audiyofan/PP-EL360/images/PP_EL36_6N2P_6F12P.png

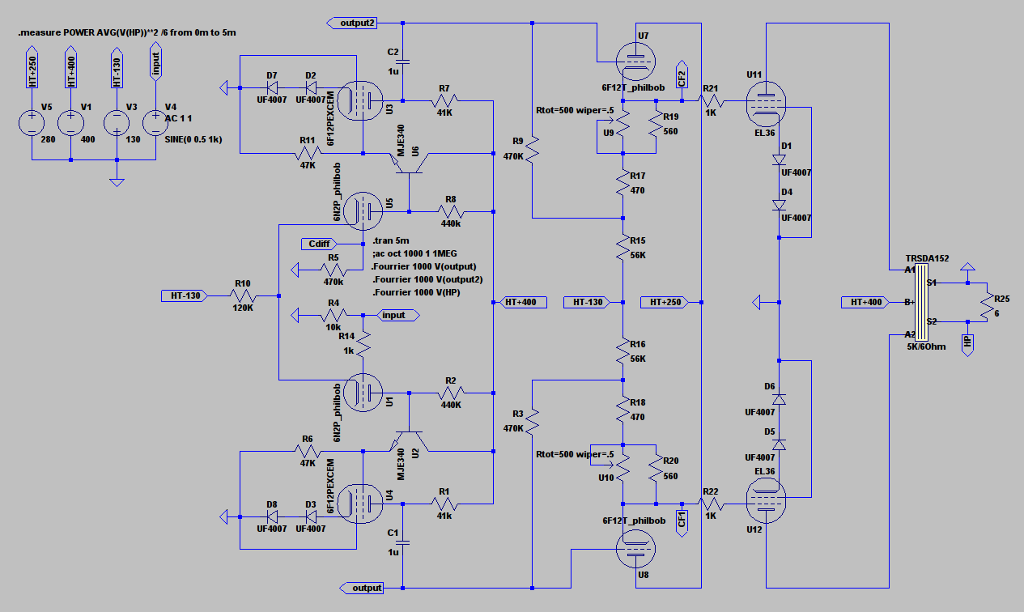
images/PP_EL36_6N2P_6F12P.png
