audiyofan/PP-EL360/images/PP_EL360_plot.png

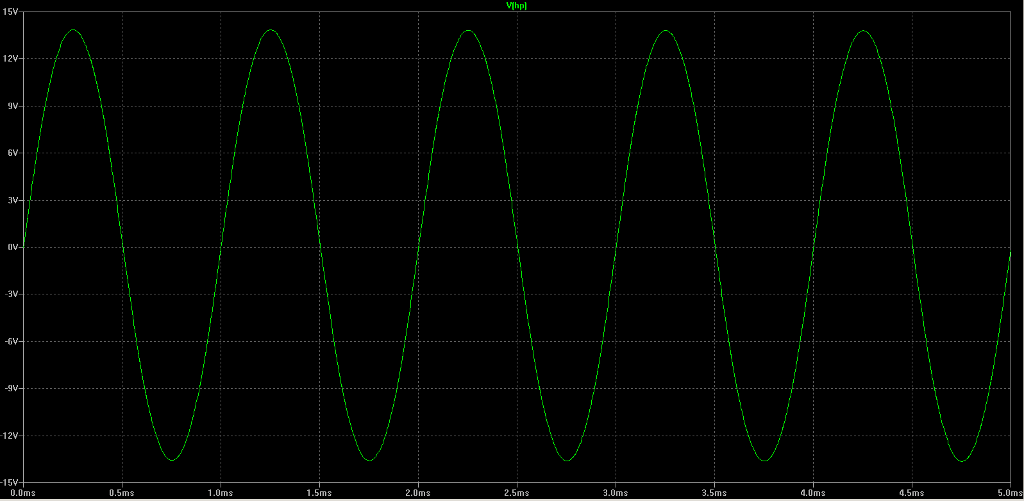
images/PP_EL360_plot.png
