audiyofan/PP-EL360/images/PP_EL360_schema.png

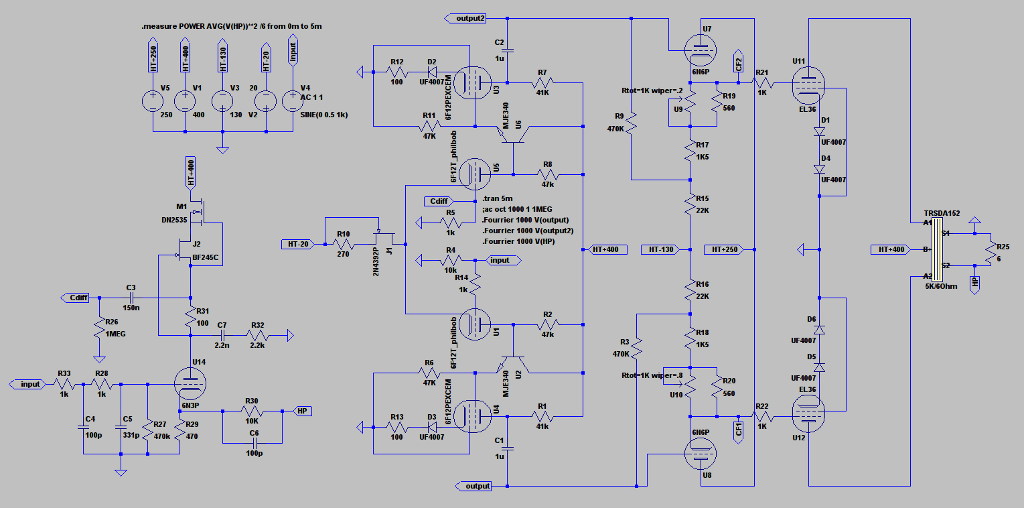
images/PP_EL360_schema.png
