audiyofan/PP-EL360/LTspiceIV/psu_neg.asc

C1: cap; 100µ; Rser=2
C2: cap; 100µ; Rser=2
C3: cap; 1m; Rser=2
C4: cap; 100µ; Rser=2
C5: cap; 50µ; Rser=.5
C6: cap; 200µ; Rser=1
C7: cap; 4.7µ
C8: cap; 15µ
C9: cap; 4.7µ; Rser=3
C10: cap; 4.7µ; Rser=3
C11: cap; 100µ
D1: zener; BZX384B9V1
D2: schottky; 1N5819
D3: schottky; 1N5819
D4: diode; 1N6513
D5: diode; 1N6513
D6: diode; 1N6513
D7: diode; 1N6513
D8: LED; XM-LRED
D9: zener; BZX384B9V1
D10: zener; 1N5378B
D11: schottky; 1N5819
D12: zener; BZX384B9V1
D15: LED; XM-LGRN
I4: current; PULSE(0m 100m 60 5u 5u 590u 1m 5000)
Q2: pnp; MJE350
R1: res; 1
R2: res; 270
R3: res; 910
R4: res; 180k
R5: res; 110k
R6: res; 180k
R7: res; 100k
R8: res; 100k
R9: res; 75
R10: res; 1800
R11: res; 120
R12: res; 450
R13: res; 11765
R14: res; 2k
R15: res; 10.57k
R16: res; 21875
R17: res; 10k
R18: res; 680k
R19: res; 6.8k
R20: res; 100k
U1: IRF820
U2: lm337
U3: IRF820
U4: IRF820
U5: IRF820
V1: voltage; SINE(0 17 50 0 0 0 3800); AC 1 1; Rser=2.35
V2: voltage; SINE(0 420 50 0 0 0 3800); AC 1 1; Rser=41.4
Named nets: 0, +320, V-, +330, +200, ref
.tran 80s
* MCR100-8  SCR  A G K  MCE  7-17-95
*MCE MCR100-8 600V  800mA  pkg:TO-226AA
.SUBCKT XMCR1008 1 2 3
*    TERMINALS:  A G K
*  600 Volt  .8 Amp  SCR  07-17-1995
QP  6 4 1  POUT OFF
QN  4 6 5  NOUT OFF
RF  6 4    120MEG
RR  1 4    80MEG
RGK 6 5    6.25K
RG  2 6    9.17
RK  3 5    81.3M
DF  6 4    ZF
DR  1 4    ZR
DGK 6 5    ZGK
.MODEL ZF   D (IS=.32F IBV=1U BV=600 RS=18MEG)
.MODEL ZR   D (IS=.32F IBV=1U BV=800)
.MODEL ZGK  D (IS=.32F IBV=1U BV=5)
.MODEL POUT PNP (IS=320F BF=1 CJE=67P)
.MODEL NOUT NPN (IS=320F BF=100 RC=.325
+ CJE=67P CJC=13.4P TF=56.6N TR=8.06U)
.ENDS XMCR1008
