audiyofan/PP-EL360/LTspiceIV/amplifier.asc

C1: cap; 1µ; Rser=0.03
C2: cap; 1µ; Rser=0.03
C3: cap; 10p
C4: cap; 12p
C6: cap; 470n
C7: cap; 2.2n
C8: cap; 270p
C9: cap; 20p
C10: cap; 12p
D1: LED; LedGreen
D2: LED; XM-LRED
D3: LED; XM-LRED
D4: LED; LedRed
I1: current; 0.8m
Q1: npn; MPSA42
Q2: npn; MPSA42
Q3: pnp; MJE350
Q4: npn; BC547C
Q5: npn; BC547C
R1: res; {Rload}
R2: res; {Rload}
R3: res; 470k
R4: res; {Rccs}
R5: res; 470k
R6: res; {Rk}
R7: res; 120
R8: res; 5.1k
R9: res; {Rccs}
R10: res; 470k
R11: res; {Rk}
R12: res; 100k
R13: res; 4.4k
R14: res; 8
R15: res; 4k
R16: res; 6k
R17: res; 470k
R18: res; 2.2k
R19: res; 240
R20: res; 470k
R21: res; 2.7k
R22: res; 120
R23: res; 4k
R24: res; 1.8k
U1: triode; 6F12PT
U2: triode; 6F12PT
U3: triode; 6F12PT
U4: tetrode_pentode; EL36
U5: triode; 6N3P-E
U6: triode; 6F12PT
U7: tetrode_pentode; EL36
U10: TRSDA6S19P
V1: voltage; SINE(200 .5m 100)
V2: voltage; SINE(330 5m 100)
V3: voltage; SINE(19.6 0.05m 100)
V4: voltage; SINE(0 0.15 1k); AC 1 1
V5: voltage; SINE(310 0.3 100)
Named nets: 0, Vneg, input, HT1, HT2, V+, V-, HT3, output, Vg1+, Vg1-, CDiff
.tran 60m
.Fourrier 1000 V(output)
.Fourrier 1000 V(V+)
.measure OUTPUT_POWER_RMS RMS(V(output))*I(R14)
;ac oct 5000 .01 10MEG
*--------------------------------
.SUBCKT TRSDA6S19P 1 2 3 4 5 PARAMS:
+Lprim = 122 ; inductance totale du primaire entre plaques en henrys
+Zpp=5000 ; impédance primaire entre plaques
+Zhp=4 ; impédance HP
+Kp = 0.33 ; rapport des prises sur l'enroulement primaire par rapport au pt central (0<KE<1)
* attention pour les utiliser il faut modifier le symbole et rajouter les pin 6 et 7 ainsi
* qu'un label P1 et P2 et rajouter ci-dessus les pin 6 et 7 dans la ligne SUBCKT ....
+Rprim=112 ; résistance totale du primaire entre plaques
+Rsec=.22 ; résistance du secondaire
+Lfp=9m ; inductance de fuite ramenée au primaire en Henry
+Ca1=79p ; capacité parasite enroulement d'anode1
+Ca2=79p ; capacité parasite enroulement d'anode2
+Ce1=300p ; capacité parasite enroulement d'écran1
+Ce2=300p ; capacité parasite enroulement d'écran2
 
LP1 8 6 {Lprim/4+Lprim*Kp*Kp/4-Lprim*Kp/2}
LP2 6 5 {Lprim*Kp*Kp/4}
LP3 5 7 {Lprim*Kp*Kp/4}
LP4 7 9 {Lprim/4+Lprim*Kp*Kp/4-Lprim*Kp/2}
LP5 10 4 {LPRIM*Zhp/Zpp}
RP1 1 8 {Rprim/2}
RP2 2 9 {Rprim/2}
RS 10 3 {Rsec}
KALL LP1 LP2 LP3 LP4 LP5 {SQRT(1-Lfp/Lprim)} ; {coeff de couplage}
c1 1 8 {Ca1}
c2 2 9 {Ca2}
c3 6 5 {Ce1}
C4 5 7 {Ce2}
.ENDS
.PARAM Rccs 270
.PARAM Rk 220
.PARAM Rload 47k
.PARAM Rloadccs 100k
parameters & measures
