audiyofan/PP-EL360/LTspiceIV/drivers.asc

C1: cap; 1µ; V=100 Irms=4.58 Rser=0.025 Lser=0 mfg="KEMET" pn="C2225C105K1RAC" type="X7R"
C2: cap; 1µ; V=100 Irms=4.58 Rser=0.025 Lser=0 mfg="KEMET" pn="C2225C105K1RAC" type="X7R"
D1: diode; UF4007
D2: diode; UF4007
D3: diode; UF4007
D4: diode; UF4007
Q1: npn; MJE340
Q2: npn; MJE340
R1: res; 56k
R2: res; 220k
R3: res; 470K
R4: res; 10k
R5: res; 58k
R6: res; 82
R7: res; 56K
R8: res; 220k
R9: res; 470K
R10: res; 1k
R11: res; 82
R14: res; 1k
R15: res; 15K
R16: res; 15K
U16: triode; 12AX7
U17: triode; 12AX7
U18: triode; 6F12PT
U19: triode; 6F12PT
U20: tetrode_pentode; 6F12PP
U21: tetrode_pentode; 6F12PP
V1: voltage; 400
V3: voltage; 130
V4: voltage; SINE(0 0.35 1k); AC 1 1
V5: voltage; 200
Named nets: input, 0, HT+400, HT-130, HT+200, CF2, CF1
.Fourrier 1000 V(CF1)
.tran 50m
.Fourrier 1000 V(CF2)
;ac oct 1000 1 1MEG
.SUBCKT 6F12PT 1 2 3 ; P G C (Triode) 07 Nov 2004
+ params:
+ mu  = 137.721
+ ex  = 1.60508
+ kg1 = 55.4076
+ kp  = 593.725
+ kvb = 11210.8
+ ccg = 4.6e-12
+ cgp = 1.6e-12
+ ccp = 2.6e-13
e1 7 0 value=
+{v(1,3)/kp*log(1+exp(kp*(1/mu+v(2,3)/sqrt(kvb+v(1,3)*v(1,3)))))}
re1 7 0 1g
g1 1 3 value= {(pwr(v(7),ex)+pwrs(v(7),ex))/kg1}
rcp 1 3 1g
c1 2 3 {ccg}
c2 1 2 {cgp}
c3 1 3 {ccp}
.ENDS
.SUBCKT 6F12PP  1 2 3 4 ; P G1 C G2 (Pentode) 24-Dec-2004
+ PARAMS: MU= 71.45  EX= 1.350  KG1= 260.8  KP=7396.95   KC= 75
+ KVB=  17.9  VCT=  0.00 RGI=  4500k
+ CCG=6.6P  CPG1=0.02P CCP=1.9P
RE1  7 0  1MEG    
E1   7 0  VALUE=  ; E1 BREAKS UP LONG EQUATION FOR G1.
+{V(4,3)/KP*LN(1+EXP((1/MU+V(2,3)/V(4,3))*KP))}
G1   1 3  VALUE={(PWR(V(7),EX)+PWRS(V(7),EX))/KG1*1.57*TANH(2*V(1,3)/(KVB*3.14159))}
G2   4 3  VALUE={STP(((EXP(EX*(LN((V(4,3)/MU)+V(2,3)))))/KC)-((PWR(V(7),EX)+PWRS(V(7),EX))/KG1*1.57*TANH(2*V(1,3)/(KVB*3.14159))))
+*(((EXP(EX*(LN((V(4,3)/MU)+V(2,3)))))/KC)-((PWR(V(7),EX)+PWRS(V(7),EX))/KG1*1.57*TANH(2*V(1,3)/(KVB*3.14159))))}
RCP  1 3  1G      ; FOR CONVERGENCE
C1   2 3  {CCG}   ; CATHODE-GRID 1
C2   1 2  {CPG1}  ; GRID 1-PLATE
C3   1 3  {CCP}   ; CATHODE-PLATE
R1   2 5  {RGI}   ; FOR GRID CURRENT
D3   5 3  DX      ; FOR GRID CURRENT
.MODEL DX D(IS=1N RS=1 CJO=10PF TT=1N)
.ENDS
