audiyofan/PP-EL360/(threads)

Thread 1 (2015-10-30):

+200V power supply starts with positive offset

chanmix51, 2015-10-30:
The +200V power supply is provided by an IRF polarized by a CCS. The FET’s gate is not decoupled so it will start with a positive offset that will set the EL360’s grid 2 to a positive offset at start up.

[Bug report](http://www.audiyofan.org/forum/viewtopic.php?f=60&t=9195&p=117088#p117088) (french)

chanmix51, 2015-11-14:
Fixed in 0a6318e

Closed 2015-11-14.
