audiyofan/PP-EL360/(commit log)

2014-09-13 Rajoût des modèles 6N6P & EL36, et une ébauche de PP
2014-09-14 Ajoût de la Cdiff avec une 6N3P
2014-09-14 Ajouté def. tubes.
2015-03-23 Use triode mode for entry stage.
2015-03-30 Add schematics.
2015-04-04 Set a better CCS in preamp stage.
2015-04-06 Update schematics with PSRR.
2015-04-08 Add NPN -20V regulation.
2015-04-10 Add power stage schematic.
2015-04-10 Add licence terms on schematics.
2015-04-10 Change PSU schematic s font.
2015-04-11 Fix schematics components values.
2015-04-11 Remove EL360 LED biasing.
2015-04-18 Switch 6F12P pentodes and triodes.
2015-10-25 Fix schematic bad G2 connection
2015-11-04 Fix EL360 g1 grid current problem
    Since the EL360 grid 1 are almost 0 they are subject to grid current. As
    they are biased through resistors, this makes the final stage to
    oscilate at high frequency.
2015-11-06 Change 6N3P to 6N17B
    Because the correction circuit uses a differential amplifier, its gain
    is devided by 2. With µ=35 it makes a 6N3P to provide a gain between 10
    and 15. In order to get a good enough damping factor, a higher gain is
    desirable while keeping the CMRR and PSRR of the 6N3P. The 6N17B has
    been found as beeing a suitable replacement giving an estimated gain of
    28 with a comparable ripple rejection ratio and with a better protection
    against microphony.
2015-11-13 Replace CDiff with 6N3P µ-follower
    As stated, the differential pair was not worth two tubes to present
    normal PSRR and CMRR to the 0V. A FET driven µ-follower has been
    prefered. It presents a load of 500k and an output impedance of less
    than 100Ω while keeping noise away from the FET’s source. The µ-follower
    has also the advantage of having two outputs: one (used here) is the
    FET’s source and the other is the high impedance valve’s anode. This is
    a perfect place to set a damping circuit if needed.
2015-11-14 Use LM in negative regulated power supply
    A LM happily replaces the BC338 in the negative PSU. With a RC filter it
    makes the ripple voltage under 0,1mV without further changes.
2015-11-22 Rearrange PSU and drivers
    With 300Vac output at main transformer, we are able to get a regulated
    330Vdc for drivers. Still, it presents a 10mV ripple @ 100Hz. The
    regulated 200Vdc does not present such ripple. The CDiff can be powered
    from the 200V since it uses a FET µ-follower.
    PSU currents have been simulated to check the amplifier can stand
    maximum output without the PSU to choke.
    The regulation is now preceded by a RC filter that lowers the ripple of
    6dB.
2016-03-09 raise Rgrid right to 470k
    Because we use a mechanical switch to shortcut the output when switched
    off, there is no need to limit the PLOP when the voltage suddenly drops
    in the correction stage.
2016-03-28 add BJT cascode in the input stage
2016-09-07 update schematics to first working version
    CCS bias resistors values are based on real values
    CDiff filters are updated as well
    Added a NPN in the EL360’s g2 grid circuit. This shown improvements in
    the max power the amplifier could output (25W instead of 20W) using only
    one way.
2016-09-10 lower Δ BW
    This makes better squares at 20kHz.
2016-09-10 lower I in EL360 grid track
    In order to save some precious -20V PSU milliamps.
2016-09-25 lower the quiescent flow in EL360
2016-09-28 add thermistor in PSU shunt
    The shunt was not correctly going off due to the overvoltage of the main
    transformer. It kept pulling 40mA from the PSU and heating uselessly the
    25W shunt resistor. The thermistor is screwed on the regulator heatsink.
    As soon as the heatsink is warm, the shunt goes off. Those 16W saved
    allow the amplifier to deliver 2×20W RMS.
